bseverns/DiceLoop/hardware/wiring/dice-loop-schematic.md

# DiceLoop Schematic Notes

This file is generated by `scripts/generate_schematic.py`.

- OLED: Included

## Key Connections

| From | To | Signals |
| --- | --- | --- |
| Teensy 4.0 | Control pots | A0/A1/A3/A4/A5, 3.3V, GND |
| Teensy 4.0 | Chaos buttons | D7, D8, GND (internal pull-ups) |
| Teensy 4.0 | Tap footswitch (optional) | D6, GND (internal pull-up) |
| Teensy 4.0 | LED bar + 74HC595 | D2 (SER), D3 (RCLK), D4 (SRCLK), 3.3V, GND |
| Teensy 4.0 | Audio shield | I2S stack, MCLK 23, SCK 13, SDA/SCL |
| Teensy 4.0 | SSD1306 OLED | SDA 18, SCL 19, 3.3V, GND |

## Notes

- Pots are 10k linear, 0-3.3 V swing.
- Buttons short to ground; Teensy uses internal pull-ups.
- Shift register outputs need 330R current-limiting resistors.
