bseverns/DiceLoop/(list of files, cad)

Other CAD files:
hardware/enclosure/tabletop-enclosure/dice-loop-panel.dxf
