bseverns/DiceLoop/(list of files, drawings)

Other design files:
hardware/wiring/dice-loop-wiring.fzz
