bseverns/DiceLoop/hardware/wiring/dice-loop-schematic.kicad_sch

## KiCad design hardware/wiring/dice-loop-schematic.kicad_sch (2026-05-29)

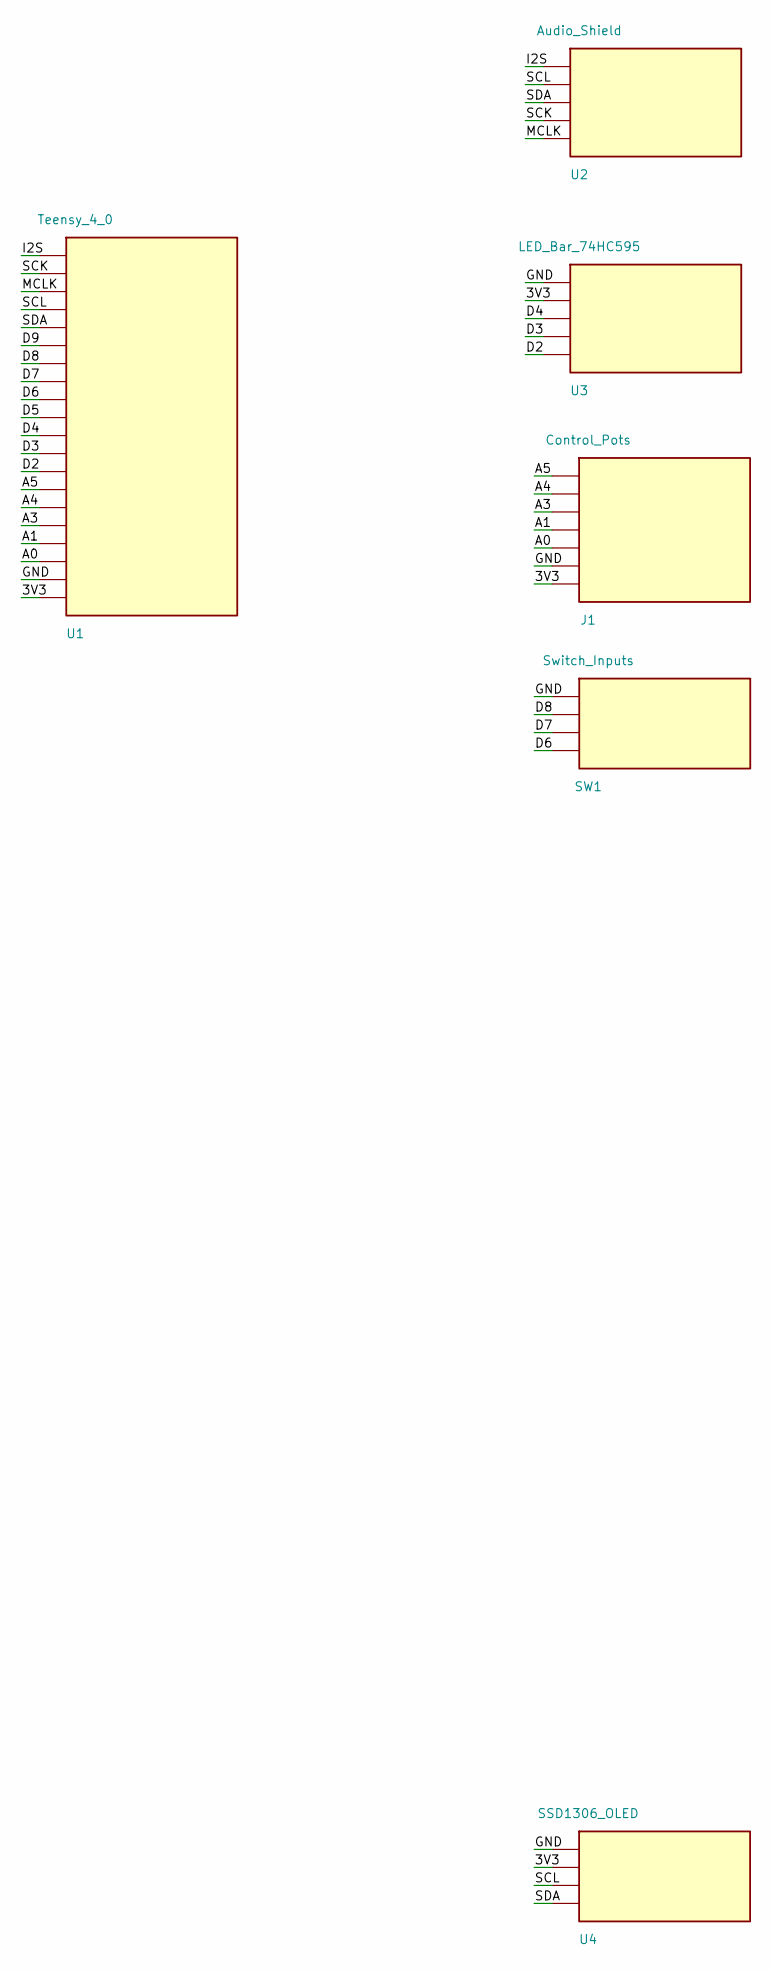
[picture p1: schematic dice-loop-schematic.kicad_sch]

Parts:
J1: Control_Pots
SW1: Switch_Inputs
U1: Teensy_4_0
U2: Audio_Shield
U3: LED_Bar_74HC595
U4: SSD1306_OLED

Connections:
3V3: J1.7 (A5), U1.20 (I2S), U3.2 (D3), U4.2 (SCL)
A0: J1.5 (A3), U1.18 (MCLK)
A1: J1.4 (A1), U1.17 (SCL)
A3: J1.3 (A0), U1.16 (SDA)
A4: J1.2 (GND), U1.15 (D9)
A5: J1.1 (3V3), U1.14 (D8)
D2: U1.13 (D7), U3.5 (GND)
D3: U1.12 (D6), U3.4 (3V3)
D4: U1.11 (D5), U3.3 (D4)
D5: U1.10 (D4)
D6: SW1.4 (GND), U1.9 (D3)
D7: SW1.3 (D8), U1.8 (D2)
D8: SW1.2 (D7), U1.7 (A5)
D9: U1.6 (A4)
GND: J1.6 (A4), SW1.1 (D6), U1.19 (SCK), U3.1 (D2), U4.1 (SDA)
I2S: U1.1 (3V3), U2.1 (MCLK)
MCLK: U1.3 (A0), U2.5 (I2S)
SCK: U1.2 (GND), U2.4 (SCL)
SCL: U1.4 (A1), U2.2 (SCK), U4.3 (3V3)
SDA: U1.5 (A3), U2.3 (SDA), U4.4 (GND)
