bseverns/DiceLoop/(commit log)

2025-07-01 Implement density and noise controls
    [audio_pipeline.cpp]
2025-10-19 Rename project from teensyDee2 to DiceLoop
2025-11-07 Add hardware lab docs and placeholders
    [dice-loop-panel.dxf, dice-loop-wiring.fzz, panel-bom.csv]
2025-11-07 Adapt audio pipeline to newer Teensy Audio APIs
2025-11-07 Add Teensy audio compatibility shims
2025-11-07 Fix mixer gain dispatch ambiguity
    [audio_compat.h]
2025-11-07 Ensure Teensy core headers are pre-included
2025-11-07 Enable SGTL5000 front-end for Teensy 4 delay builds
2025-11-07 Add kinetis shim for Teensy 4 audio builds
2025-11-07 Use Teensy 4 ready Audio library
2025-11-07 Rely on Teensyduino-bundled Audio library
2025-11-07 Document chaos mixing flow
2025-11-07 Document chaos engine in signal flow
2025-11-07 Update README to remove obsolete ADC and CI details
    Removed outdated information about ADC and CI workflow.
2025-11-07 Stage delay macro with bloom limiter
2025-11-15 Update LED bar firmware docs
2025-11-15 Add wiring harness diagram and embed in docs
2025-11-15 Refactor dirt engine into pluggable stages
2025-11-15 Declare dirt stage helpers before use
2025-11-15 Add EEPROM-backed dirt stage presets
2025-11-15 Fix USB MIDI include path
    [tempo_sync.cpp]
2025-11-15 Tighten USB MIDI guards
    [tempo_sync.cpp]
2025-11-15 Track bloom limiter and ghost feedback chaos offsets
2025-11-15 Fix cmath usage for tempo sync
    [tempo_sync.cpp]
2025-12-21 Wire UI preset overlay to preset manager
2025-12-25 hardware beginnings
    [Untitled.kicad_pcb, Untitled.kicad_sch]
2026-01-05 Add circuit backup ZIP file
    Added a new backup file for the circuit project in the Untitled directory.
2026-01-10 Replace Untitled circuit with dice-loop schematic
    Removed the old 'Untitled' KiCad project and backup files. Added new dice-loop schematic files (KiCad schematic, documentation, and SVG) and a Python script for schematic generation.
    [Untitled.kicad_pcb, Untitled.kicad_sch, dice-loop-schematic.kicad_sch]
2026-01-10 Add native test bench and stubs for host-side testing
    Introduces a native test environment under tests/native/ with Arduino and Audio stubs, enabling firmware logic tests without hardware. Updates README and platformio.ini to document and support the new test bench. Adds initial tests for tempo sync, chaos modulator, dirt stack, and stage presets.
2026-01-11 Add offline sample rendering and test integration
    Introduces native test for offline sample rendering, writing processed WAVs to docs/sample/outputs/. Updates CI workflow to run native tests and upload rendered samples as artifacts. Adds helper functions for dirt control and test state reset in audio_pipeline. Updates .gitignore for output directory and documents new test functionality.
    [audio_pipeline.cpp, audio_pipeline.h]
2026-01-11 Refactor array fill and add AudioStream methods
    Replaced std::fill with pointer arithmetic in Arduino.h for better compatibility. Added allocate, release, receiveReadOnly, and transmit methods to AudioStream in Audio.h to enhance stub functionality for testing.
2026-01-11 Add missing Arduino constants and map function stub
    Added DEC, HEX, and analog pin constants (A0-A5) to Arduino.h stub. Implemented a stub for the map() function to improve compatibility with Arduino code in native tests.
2026-03-09 Fix doc drift and harden schematic/build tooling
    [dice-loop-schematic.kicad_sch]
2026-05-29 Schematic gen
    [dice-loop-schematic.kicad_sch]
2026-05-29 Schematic edits
    [dice-loop-schematic.kicad_sch]
2026-05-30 Update README to remove wiring diagram section
    Removed wiring diagram and description from README.
